acha666/PoE_Splitter/PoE_Splitter.kicad_pcb

## KiCad design PoE_Splitter.kicad_pcb (2026-07-12)

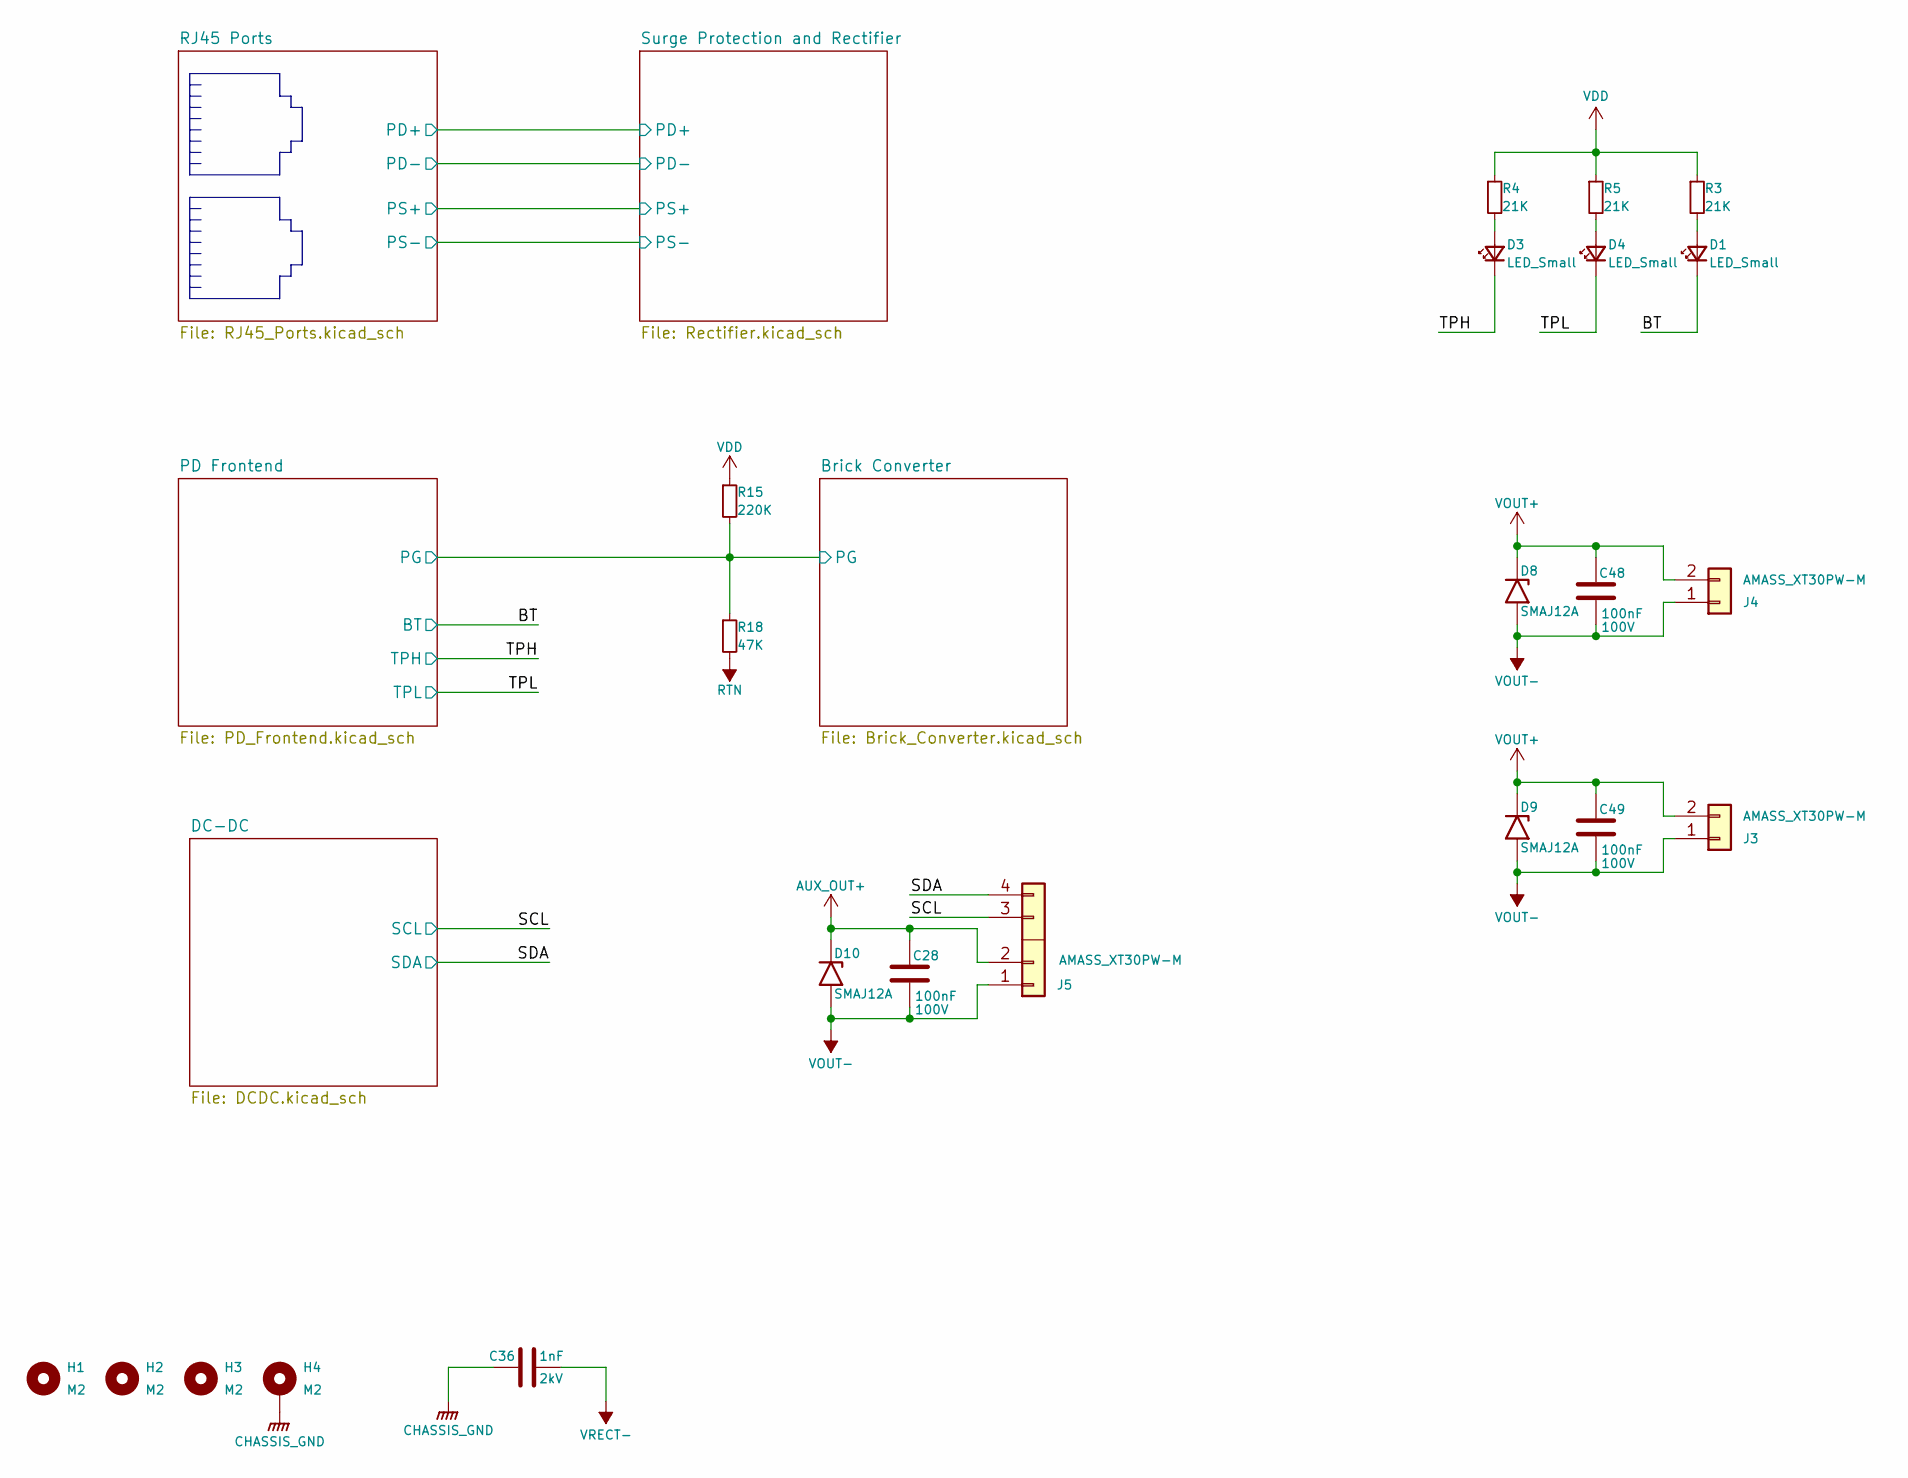
[picture p1: schematic PoE_Splitter.kicad_sch]

Parts:
C28: 100nF; C_0805_2012Metric; Rated Voltage 100V
C36: 1nF; C_1808_4520Metric; Rated Voltage 2kV
C48, C49: 100nF; C_1812_4532Metric; Rated Voltage 100V
D1, D3, D4: LED_Small; LED_0603_1608Metric
D8, D9, D10: SMAJ12A; D_SMA
H1, H2, H3: M2; MountingHole_2.2mm_M2_ISO7380
H4: M2; MountingHole_2.2mm_M2_ISO7380_Pad
J3, J4: AMASS_XT30PW-M; AMASS_XT30PW-M_1x02_P2.50mm_Horizontal
J5: AMASS_XT30PW-M; AMASS_XT30PW(2+2)-M_Horizontal
R3, R4, R5: 21K; R_0603_1608Metric
R15: 220K; R_0603_1608Metric
R18: 47K; R_0603_1608Metric

Connections:
/BT: D1.1 (K); also elsewhere on the board
/Brick Converter/PG: R15.2, R18.1; also elsewhere on the board
/SCL: J5.3 (Pin_1); also elsewhere on the board
/SDA: J5.4 (Pin_2); also elsewhere on the board
/TPH: D3.1 (K); also elsewhere on the board
/TPL: D4.1 (K); also elsewhere on the board
AUX_OUT+: C28.1, D10.1 (A1), J5.2; also elsewhere on the board
CHASSIS_GND: C36.1, H4.1 (1_1); also elsewhere on the board
unnamed: D1.2 (A), R3.2
unnamed: D3.2 (A), R4.2
unnamed: D4.2 (A), R5.2
RTN: R18.2; also elsewhere on the board
VDD: R3.1, R4.1, R5.1, R15.1; also elsewhere on the board
VOUT+: C48.1, C49.1, D8.1 (A1), D9.1 (A1), J3.2, J4.2; also elsewhere on the board
VOUT-: C28.2, C48.2, C49.2, D8.2 (A2), D9.2 (A2), D10.2 (A2), J3.1, J4.1, J5.1; also elsewhere on the board
VRECT-: C36.2; also elsewhere on the board

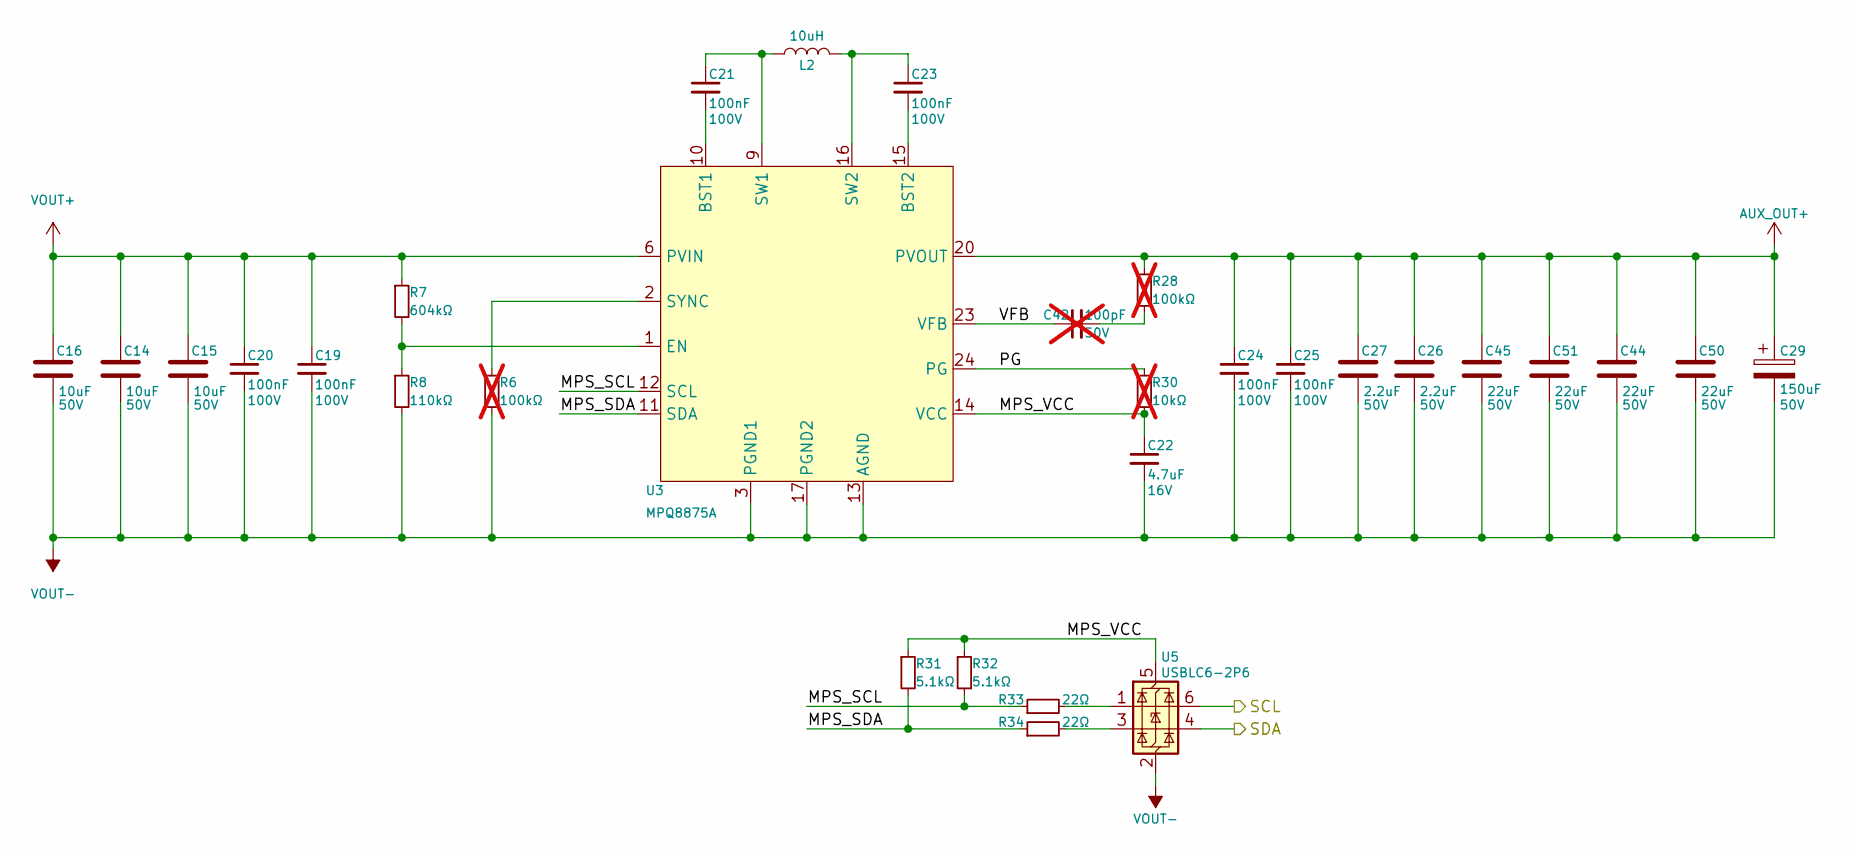
[picture p2: schematic DCDC.kicad_sch, PoE_Splitter]

Parts:
C14, C15, C16: 10uF; C_0805_2012Metric; Rated Voltage 50V
C19, C20, C21, C23, C24, C25: 100nF; C_0603_1608Metric; Rated Voltage 100V
C22: 4.7uF; C_0603_1608Metric; Rated Voltage 16V
C26, C27: 2.2uF; C_0805_2012Metric; Rated Voltage 50V
C29: 150uF; CP_Elec_6.3x7.7; Rated Voltage 50V
C42: 100pF; C_0603_1608Metric; Rated Voltage 50V; not fitted
C44, C45, C50, C51: 22uF; C_1206_3216Metric; Rated Voltage 50V
L2: 10uH; L_Chilisin_BWVS00808040
R6, R28: 100kΩ; R_0603_1608Metric; not fitted
R7: 604kΩ; R_0603_1608Metric
R8: 110kΩ; R_0603_1608Metric
R30: 10kΩ; R_0603_1608Metric; not fitted
R31, R32: 5.1kΩ; R_0603_1608Metric
R33, R34: 22Ω; R_0603_1608Metric
U3: MPQ8875A; MPS_QFN-34_4x5mm_MPQ8875A
U5: USBLC6-2P6; SOT-666

Connections:
/DC-DC/MPS_SCL: R32.2, R33.1, U3.12 (SCL)
/DC-DC/MPS_SDA: R31.2, R34.1, U3.11 (SDA)
/DC-DC/MPS_VCC: C22.1, R30.2, R31.1, R32.1, U3.14 (VCC), U5.5 (VBUS)
/DC-DC/PG: R30.1, U3.24 (PG)
/DC-DC/VFB: C42.1, U3.23 (VFB)
/SCL: U5.6 (I/O1); also elsewhere on the board
/SDA: U5.4 (I/O2); also elsewhere on the board
AUX_OUT+: C24.1, C25.1, C26.1, C27.1, C29.1, C44.1, C45.1, C50.1, C51.1, R28.1, U3.20 (PVOUT), U3.21 (PVOUT), U3.22 (PVOUT); also elsewhere on the board
unnamed: C21.1, L2.1, U3.9 (SW1), U3.28 (SW1), U3.29 (SW1), U3.30 (SW1)
unnamed: C23.1, L2.2, U3.16 (SW2), U3.25 (SW2), U3.31 (SW2), U3.32 (SW2)
unnamed: C42.2, R28.2
unnamed: R33.2, U5.1 (I/O1)
unnamed: R34.2, U5.3 (I/O2)
unnamed: C21.2, U3.10 (BST1)
unnamed: C23.2, U3.15 (BST2)
unnamed: R7.2, R8.1, U3.1 (EN)
unnamed: R6.1, U3.2 (SYNC)
VOUT+: C14.1, C15.1, C16.1, C19.1, C20.1, R7.1, U3.6 (PVIN), U3.7 (PVIN), U3.8 (PVIN), U3.27 (PVIN), U3.34 (PVIN); also elsewhere on the board
VOUT-: C14.2, C15.2, C16.2, C19.2, C20.2, C22.2, C24.2, C25.2, C26.2, C27.2, C29.2, C44.2, C45.2, C50.2, C51.2, R6.2, R8.2, U3.3 (PGND1), U3.4 (PGND1), U3.5 (PGND1), U3.13 (AGND), U3.17 (PGND2), U3.18 (PGND2), U3.19 (PGND2), U3.26 (PGND2), U3.33 (PGND2), U5.2 (GND); also elsewhere on the board

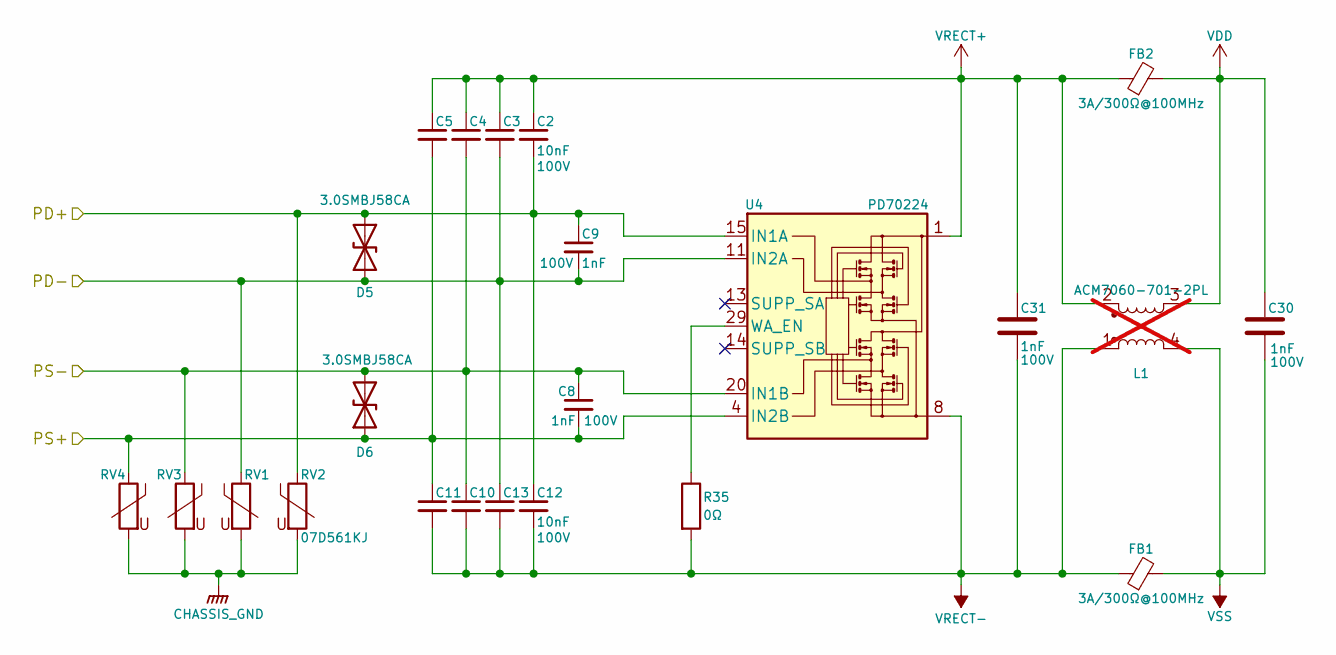
[picture p3: schematic Rectifier.kicad_sch, PoE_Splitter]

Parts:
C2, C3, C4, C5, C10, C11, C12, C13: 10nF; C_0603_1608Metric; Rated Voltage 100V
C8, C9: 1nF; C_0603_1608Metric; Rated Voltage 100V
C30, C31: 1nF; C_1206_3216Metric; Rated Voltage 100V
D5, D6: 3.0SMBJ58CA; D_SMB
FB1, FB2: 3A/300Ω@100MHz; L_0805_2012Metric
L1: ACM7060-701-2PL; L_CommonModeChoke_TDK_ACM7060; not fitted
R35: 0Ω; R_1206_3216Metric
RV1, RV2, RV3, RV4: 07D561KJ; RV_Disc_D9mm_W4mm_P5mm
U4: PD70224; Microsemi_QFN-40-32-2EP_6x8mm_P0.5mm

Connections:
/RJ45 Ports/PD+: C2.2, C9.1, C12.1, D5.1 (A1), RV2.1, U4.15 (IN1A), U4.16 (IN1A), U4.27 (IN1A), U4.28 (IN1A); also elsewhere on the board
/RJ45 Ports/PD-: C3.2, C9.2, C13.1, D5.2 (A2), RV1.1, U4.11 (IN2A), U4.12 (IN2A), U4.31 (IN2A), U4.32 (IN2A); also elsewhere on the board
/RJ45 Ports/PS+: C5.2, C8.2, C11.1, D6.1 (A1), RV4.1, U4.4 (IN2B), U4.5 (IN2B), U4.6 (IN2B), U4.7 (IN2B); also elsewhere on the board
/RJ45 Ports/PS-: C4.2, C8.1, C10.1, D6.2 (A2), RV3.1, U4.20 (IN1B), U4.21 (IN1B), U4.22 (IN1B), U4.23 (IN1B); also elsewhere on the board
CHASSIS_GND: RV1.2, RV2.2, RV3.2, RV4.2; also elsewhere on the board
unnamed: R35.1, U4.29 (WA_EN)
VDD: C30.1, FB2.2, L1.3; also elsewhere on the board
VRECT+: C2.1, C3.1, C4.1, C5.1, C31.1, FB2.1, L1.2, U4.1, U4.2, U4.3, U4.24, U4.25, U4.26, U4.33
VRECT-: C10.2, C11.2, C12.2, C13.2, C31.2, FB1.1, L1.1, R35.2, U4.8, U4.9, U4.10, U4.17, U4.18, U4.19, U4.34; also elsewhere on the board
VSS: C30.2, FB1.2, L1.4; also elsewhere on the board

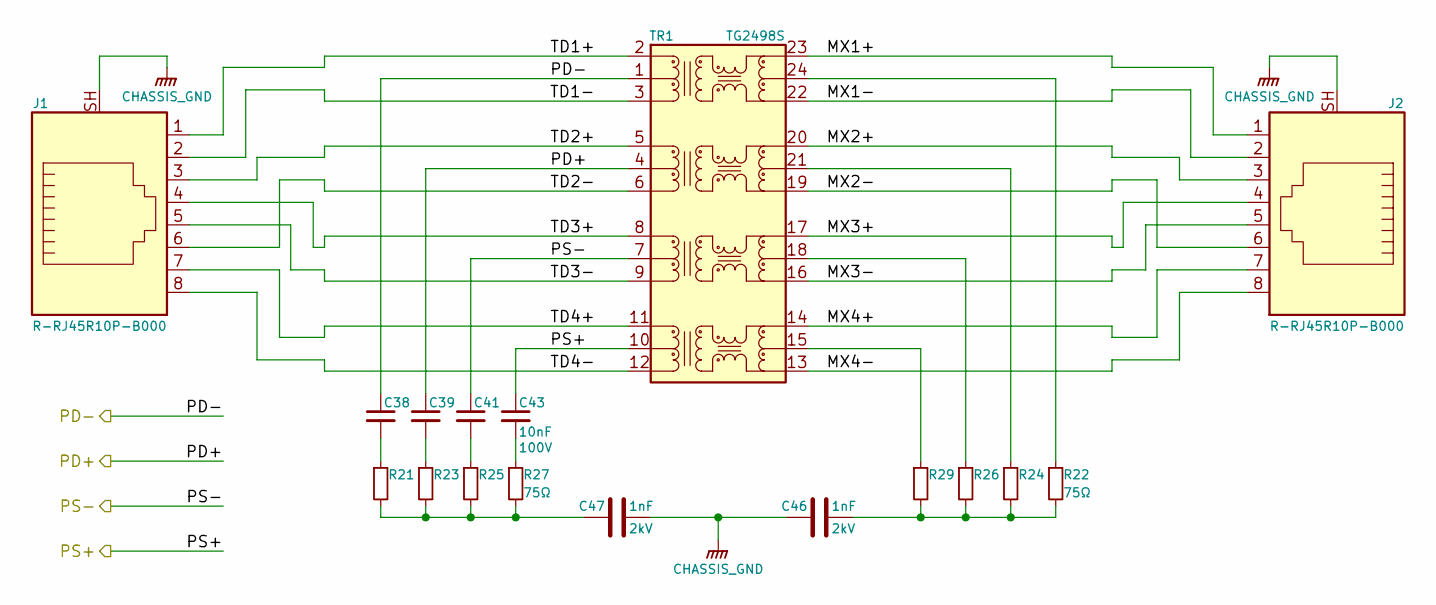
[picture p4: schematic RJ45_Ports.kicad_sch, PoE_Splitter]

Parts:
C38, C39, C41, C43: 10nF; C_0603_1608Metric; Rated Voltage 100V
C46, C47: 1nF; C_1808_4520Metric; Rated Voltage 2kV
J1, J2: R-RJ45R10P-B000; RJ45_Ckmtw_R-RJ45R10P-B000
R21, R22, R23, R24, R25, R26, R27, R29: 75Ω; R_0603_1608Metric
TR1: TG2498S; Transformer_Ethernet_CNDTek_TG2498S

Connections:
/RJ45 Ports/MX1+: J2.1, TR1.23 (MX1+)
/RJ45 Ports/MX1-: J2.2, TR1.22 (MX1-)
/RJ45 Ports/MX2+: J2.3, TR1.20 (MX2+)
/RJ45 Ports/MX2-: J2.6, TR1.19 (MX2-)
/RJ45 Ports/MX3+: J2.4, TR1.17 (MX3+)
/RJ45 Ports/MX3-: J2.5, TR1.16 (MX3-)
/RJ45 Ports/MX4+: J2.7, TR1.14 (MX4+)
/RJ45 Ports/MX4-: J2.8, TR1.13 (MX4-)
/RJ45 Ports/PD+: C39.1, TR1.4 (TCT2); also elsewhere on the board
/RJ45 Ports/PD-: C38.1, TR1.1 (TCT1); also elsewhere on the board
/RJ45 Ports/PS+: C43.1, TR1.10 (TCT4); also elsewhere on the board
/RJ45 Ports/PS-: C41.1, TR1.7 (TCT3); also elsewhere on the board
/RJ45 Ports/TD1+: J1.1, TR1.2 (TD1+)
/RJ45 Ports/TD1-: J1.2, TR1.3 (TD1-)
/RJ45 Ports/TD2+: J1.3, TR1.5 (TD2+)
/RJ45 Ports/TD2-: J1.6, TR1.6 (TD2-)
/RJ45 Ports/TD3+: J1.4, TR1.8 (TD3+)
/RJ45 Ports/TD3-: J1.5, TR1.9 (TD3-)
/RJ45 Ports/TD4+: J1.7, TR1.11 (TD4+)
/RJ45 Ports/TD4-: J1.8, TR1.12 (TD4-)
CHASSIS_GND: C46.1, C47.2, J1.SH, J2.SH; also elsewhere on the board
unnamed: C38.2, R21.1
unnamed: C39.2, R23.1
unnamed: C41.2, R25.1
unnamed: C43.2, R27.1
unnamed: C46.2, R22.2, R24.2, R26.2, R29.2
unnamed: C47.1, R21.2, R23.2, R25.2, R27.2
unnamed: R22.1, TR1.24 (MCT1)
unnamed: R24.1, TR1.21 (MCT2)
unnamed: R26.1, TR1.18 (MCT3)
unnamed: R29.1, TR1.15 (MCT4)

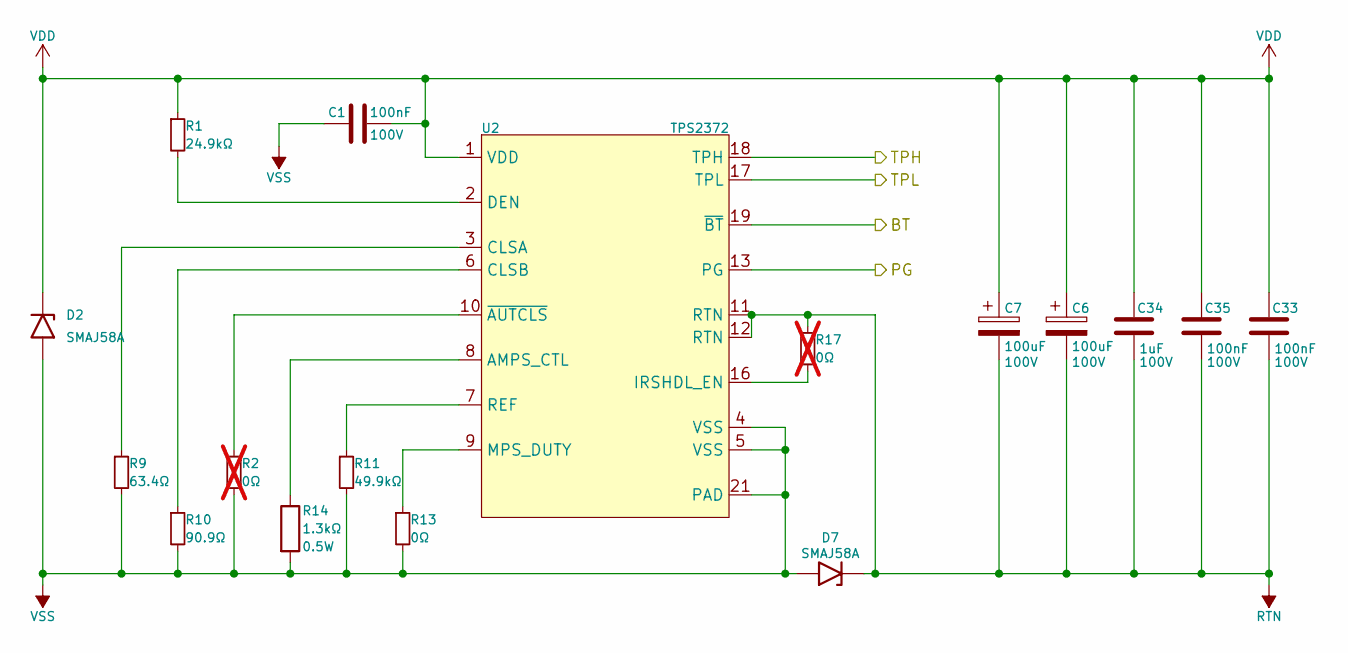
[picture p5: schematic PD_Frontend.kicad_sch, PoE_Splitter]

Parts:
C1: 100nF; C_0603_1608Metric; Rated Voltage 100V
C6, C7: 100uF; CP_Radial_D10.0mm_P5.00mm; Rated Voltage 100V
C33, C35: 100nF; C_1812_4532Metric; Rated Voltage 100V
C34: 1uF; C_1812_4532Metric; Rated Voltage 100V
D2, D7: SMAJ58A; D_SMA
R1: 24.9kΩ; R_0603_1608Metric
R2, R17: 0Ω; R_0603_1608Metric; not fitted
R9: 63.4Ω; R_0603_1608Metric
R10: 90.9Ω; R_0603_1608Metric
R11: 49.9kΩ; R_0603_1608Metric
R13: 0Ω; R_0603_1608Metric
R14: 1.3kΩ; R_0805_2012Metric
U2: TPS2372; Texas_RGW0020A_VQFN-20-1EP_5x5mm_P0.65mm_EP3.15x3.15mm

Connections:
/BT: U2.19 (~BT); also elsewhere on the board
/Brick Converter/PG: U2.13 (PG); also elsewhere on the board
/TPH: U2.18 (TPH); also elsewhere on the board
/TPL: U2.17 (TPL); also elsewhere on the board
unnamed: R14.1, U2.8 (AMPS_CTL)
unnamed: R9.1, U2.3 (CLSA)
unnamed: R10.1, U2.6 (CLSB)
unnamed: R1.2, U2.2 (DEN)
unnamed: R17.2, U2.16 (IRSHDL_EN)
unnamed: R13.1, U2.9 (MPS_DUTY)
unnamed: R11.1, U2.7 (REF)
unnamed: R2.1, U2.10 (~AUTCLS)
RTN: C6.2, C7.2, C33.2, C34.2, C35.2, D7.1 (A1), R17.1, U2.11 (RTN), U2.12 (RTN); also elsewhere on the board
VDD: C1.2, C6.1, C7.1, C33.1, C34.1, C35.1, D2.1 (A1), R1.1, U2.1 (VDD); also elsewhere on the board
VSS: C1.1, D2.2 (A2), D7.2 (A2), R2.2, R9.2, R10.2, R11.2, R13.2, R14.2, U2.4 (VSS), U2.5 (VSS), U2.21 (PAD); also elsewhere on the board

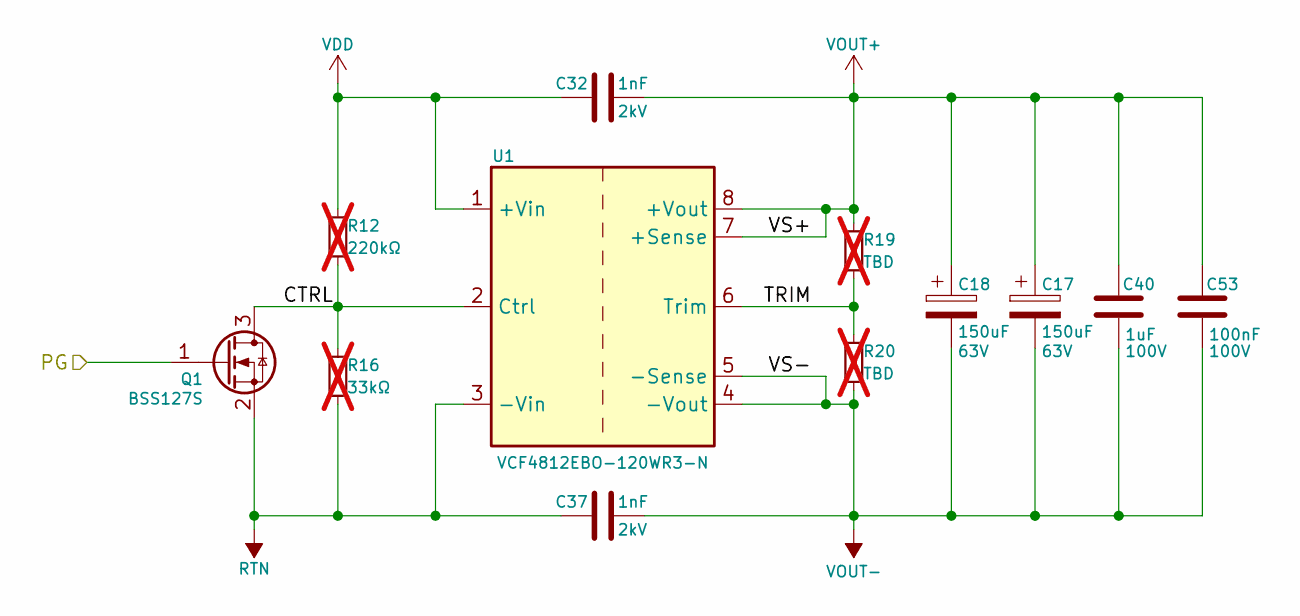
[picture p6: schematic Brick_Converter.kicad_sch, PoE_Splitter]

Parts:
C17, C18: 150uF; CP_Radial_D10.0mm_P5.00mm; Rated Voltage 63V
C32, C37: 1nF; C_1812_4532Metric; Rated Voltage 2kV
C40: 1uF; C_1812_4532Metric; Rated Voltage 100V
C53: 100nF; C_1812_4532Metric; Rated Voltage 100V
Q1: BSS127S; SOT-23
R12: 220kΩ; R_0603_1608Metric; not fitted
R16: 33kΩ; R_0603_1608Metric; not fitted
R19, R20: TBD; R_0603_1608Metric; not fitted
U1: VCF4812EBO-120WR3-N; Converter_DCDC_Eighth_Brick

Connections:
/Brick Converter/CTRL: Q1.3 (D), R12.2, R16.1, U1.2 (Ctrl)
/Brick Converter/PG: Q1.1 (G); also elsewhere on the board
/Brick Converter/TRIM: R19.2, R20.1, U1.6 (Trim)
RTN: C37.1, Q1.2 (S), R16.2, U1.3 (-Vin); also elsewhere on the board
VDD: C32.1, R12.1, U1.1 (+Vin); also elsewhere on the board
VOUT+: C17.1, C18.1, C32.2, C40.1, C53.1, R19.1, U1.7 (+Sense), U1.8 (+Vout); also elsewhere on the board
VOUT-: C17.2, C18.2, C37.2, C40.2, C53.2, R20.2, U1.4 (-Vout), U1.5 (-Sense); also elsewhere on the board

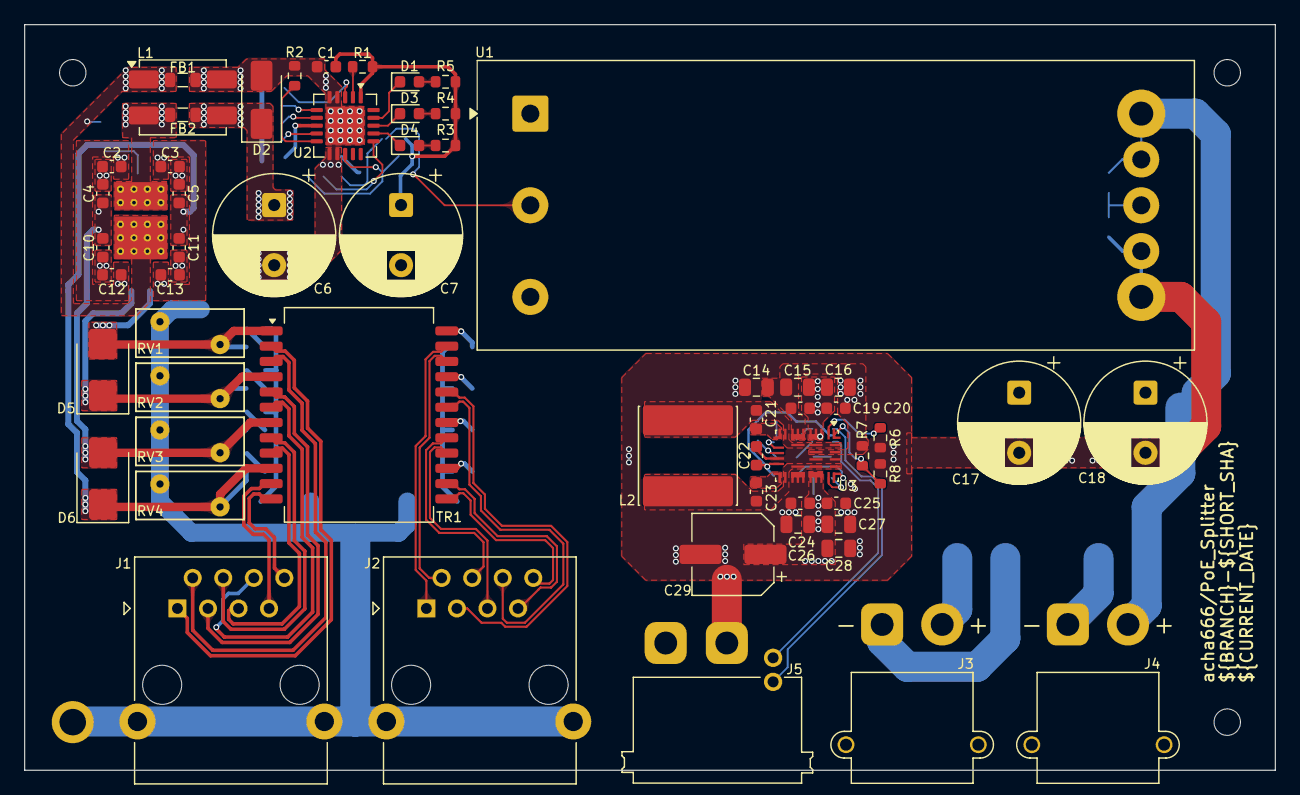
[picture p7: board PoE_Splitter.kicad_pcb from above]

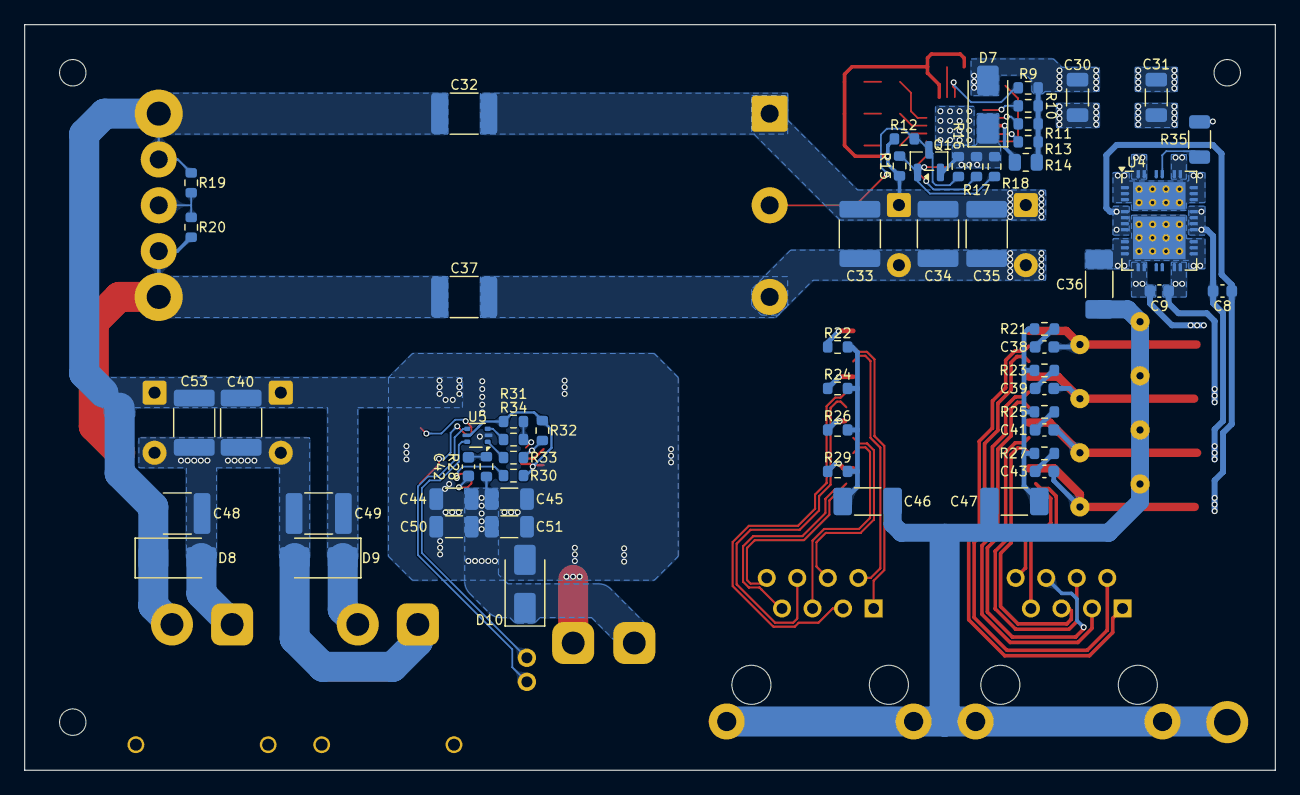
[picture p8: board PoE_Splitter.kicad_pcb from below]

Board: 2 copper layers, 104.0 x 62.0 mm, 121 parts (59 on the bottom side), 73 nets.
