acha666/PoE_Splitter/(commit log)

2026-06-30 add ci
    [Brick_Converter.kicad_sch, DCDC.kicad_sch, PD_Frontend.kicad_sch, PoE_Splitter.kicad_pcb, PoE_Splitter.kicad_sch, RJ45_Ports.kicad_sch, Rectifier.kicad_sch]
2026-06-30 fix drc exclusions
    [PoE_Splitter.kicad_pcb]
2026-06-30 reduce POWER netclass clearance
    [PoE_Splitter.kicad_pcb]
2026-06-30 fix 3d model ref
    [PoE_Splitter.kicad_pcb]
2026-06-30 add desc text
    [PoE_Splitter.kicad_pcb]
2026-06-30 add sheet titles
    [Brick_Converter.kicad_sch, DCDC.kicad_sch, PD_Frontend.kicad_sch, PoE_Splitter.kicad_pcb, PoE_Splitter.kicad_sch, RJ45_Ports.kicad_sch, Rectifier.kicad_sch]
2026-06-30 MPQ boost cap value MPQ PG pull-up res all res value unit naming
    [Brick_Converter.kicad_sch, DCDC.kicad_sch, PD_Frontend.kicad_sch, PoE_Splitter.kicad_pcb, RJ45_Ports.kicad_sch]
2026-06-30 refresh teardrops
    [PoE_Splitter.kicad_pcb]
2026-07-01 fix pcb export params
    [PoE_Splitter.kicad_pcb]
2026-07-04 minor cap footprint and value changes
    [Brick_Converter.kicad_sch, PD_Frontend.kicad_sch, PoE_Splitter.kicad_pcb, PoE_Splitter.kicad_sch]
2026-07-05 fix: pd70224 input connection
    [PoE_Splitter.kicad_pcb, Rectifier.kicad_sch]
2026-07-05 move connectors update 3d models
    [PoE_Splitter.kicad_pcb]
2026-07-07 change C29 footprint XT30 3d model position
    [DCDC.kicad_sch, PoE_Splitter.kicad_pcb]
2026-07-07 value text visibility on Fab layer
    [PoE_Splitter.kicad_pcb]
2026-07-11 J5 footprint polarity
    [PoE_Splitter.kicad_pcb]
2026-07-12 fix min track width apply teardrops
    [PoE_Splitter.kicad_pcb]
