acha666/PoE_Splitter/(notices)

Notices in the files:
PoE_Splitter.kicad_pcb:
GPL-3.0 Licensed
